FOSTI-UMS/esp32-doorlock/README.md

# Sistem Kunci Pintu dengan Sidik Jari Menggunakan ESP32

## Deskripsi
Proyek ini merupakan sistem pengunci pintu yang memanfaatkan teknologi sidik jari dengan menggunakan perangkat ESP32. Sistem ini memberikan tingkat keamanan yang optimal karena setiap individu memiliki sidik jari yang unik, sehingga hanya orang yang terdaftar yang dapat mengakses. Selain itu, proyek ini juga dapat mencegah potensi pembobolan, memberikan keamanan tambahan, dan memberikan tampilan yang lebih modern.

## Pembaharuan dari Versi Sebelumnya
Dalam versi terbaru ini, kami telah melakukan beberapa pembaruan untuk meningkatkan pengalaman pengguna, antara lain:

1. **Pembaruan Tampilan:**
   - Tampilan sistem kunci pintu telah diperbarui untuk memberikan kesan rapi, aman, dan portabel.

2. **Penambahan LCD:**
   - Kami menambahkan layar LCD untuk memberikan informasi lebih rinci kepada pengguna, seperti status kunci dan instruksi pendaftaran sidik jari.

3. **Perubahan UI:**
   - Antarmuka pengguna (UI) server telah diubah agar lebih mudah dipahami dan digunakan oleh pengguna.

4. **Penambahan Fitur:**
   - Beberapa fitur baru telah ditambahkan untuk meningkatkan fungsionalitas sistem, seperti hapus data sidik jari dan empty database.

5. **Pembaruan Perkabelan:**
   - Perkabelan sistem telah diperbarui untuk meningkatkan stabilitas dan kinerja keseluruhan.

## Daftar Isi
- [How to Install Door-Lock System](https://github.com/FOSTI-UMS/esp32-doorlock/blob/main/Manual%20User%20Door-lock%20System/How%20to%20install.md)
- [How to Use Door-Lock System](https://github.com/FOSTI-UMS/esp32-doorlock/blob/main/Manual%20User%20Door-lock%20System/How%20to%20use.md)

## Tim Kami
* Ahmat Zainul Muttaqin
* Muhammad Wahyu Syafi’uddin
* Muhammad Rivai Putra R
* Agung Nur Hidayat
* Muhammad Rafli Silehu
* Mhd. Farhan Lubis
* Pandu Adi Wijaya Kusuma W
* Hernanda Lilih Kusumaningtyas
* Sakha Naufal Firmansyah
* Dian Sasya Fitriani
* Almira Putri Wibowo
* Luthfiana Azzalea Afifah
* Naufal Zul Helmi Maulana
* Achmad Mustofa
