FOSTI-UMS/esp32-doorlock/assets/board/board3d.png

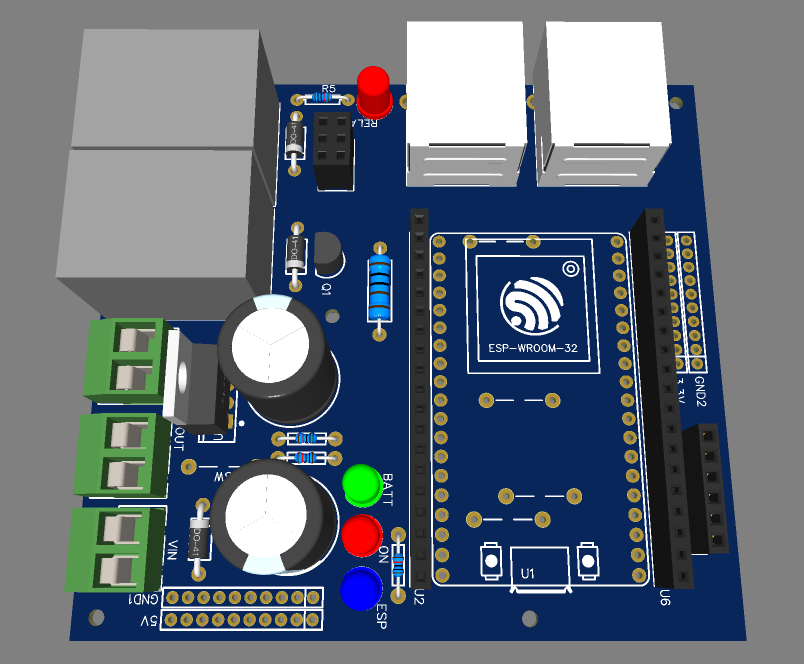
assets/board/board3d.png
