FOSTI-UMS/esp32-doorlock/assets/board/boardBottom.png

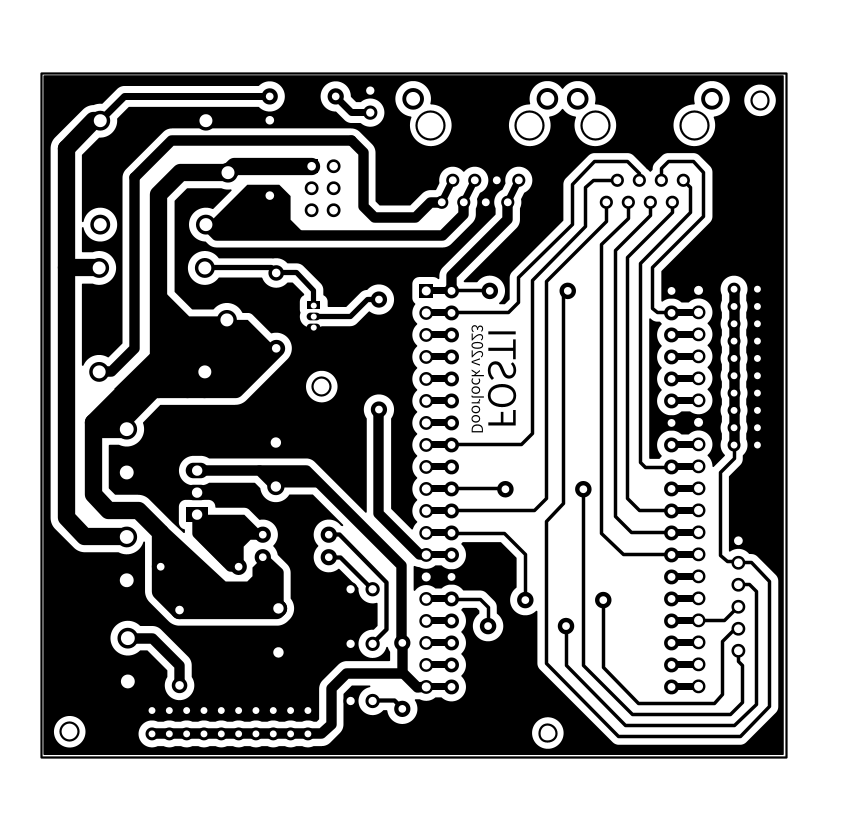
assets/board/boardBottom.png
