FOSTI-UMS/esp32-doorlock/assets/board/boardTop.png

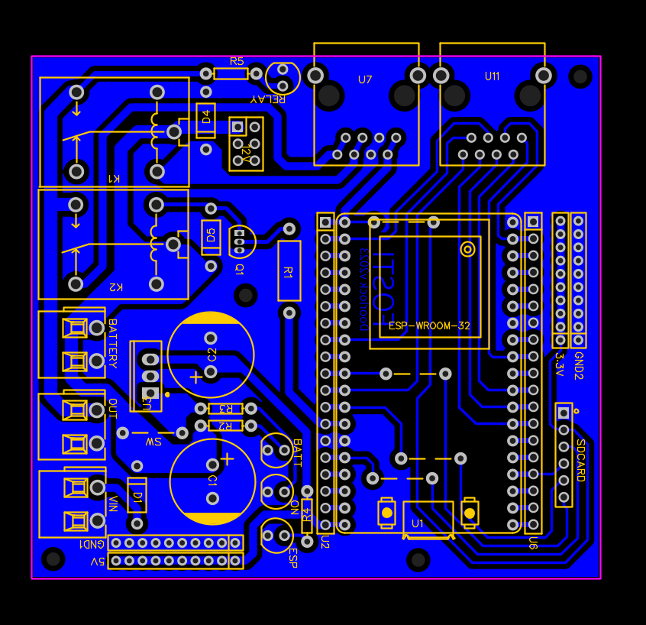
assets/board/boardTop.png
