FOSTI-UMS/esp32-doorlock/assets/board/box.jpeg

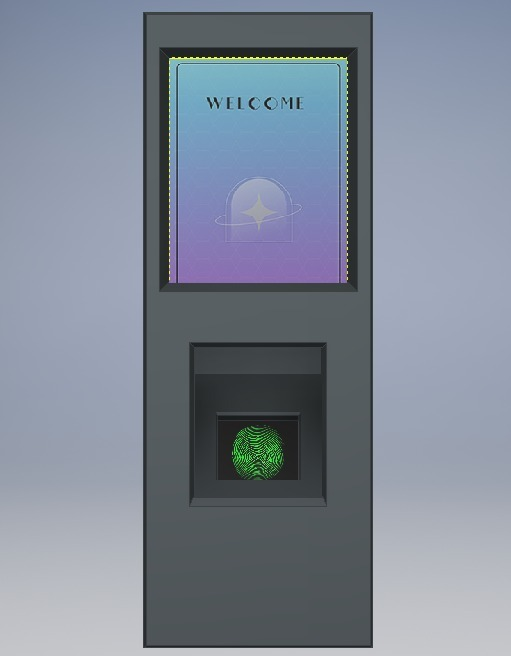
assets/board/box.jpeg
