FOSTI-UMS/esp32-doorlock/assets/board/panel3d.png

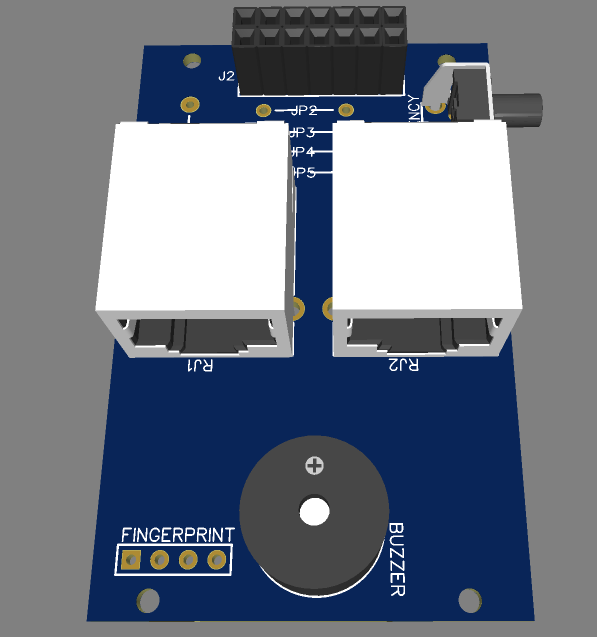
assets/board/panel3d.png
