FOSTI-UMS/esp32-doorlock/assets/board/panelBottom.png

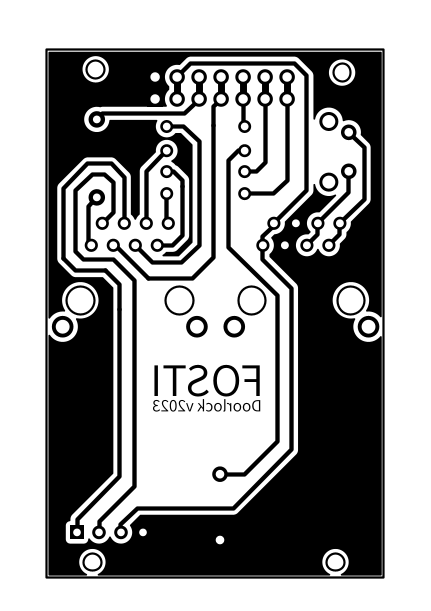
assets/board/panelBottom.png
