FOSTI-UMS/esp32-doorlock/assets/board/panelTop.png

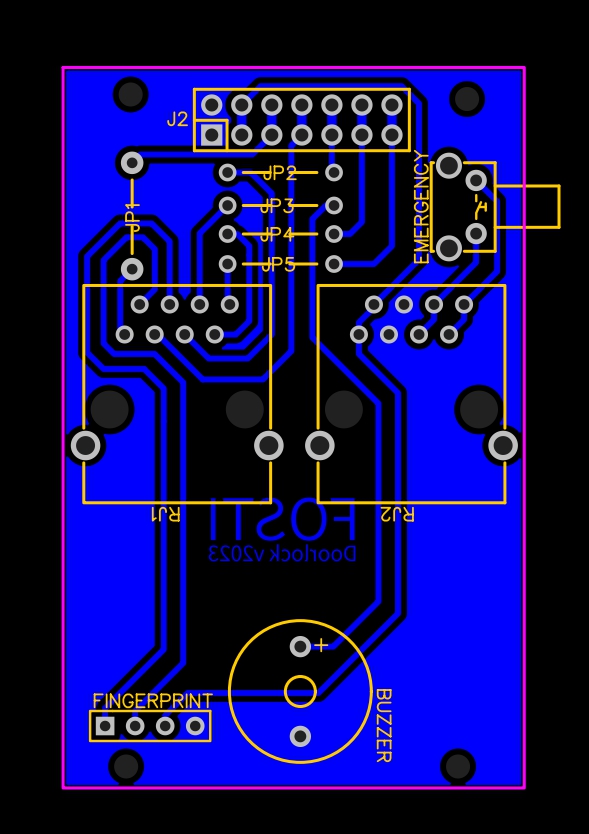
assets/board/panelTop.png
