FOSTI-UMS/esp32-doorlock/Manual User Door-lock System/How to install.md

# How to Install Door-Lock System

Powered By FOSTI UMS

✨ Door-lock system with fingerprint✨  

## Installation
### Langkah 1: Menyiapkan Alat dan Bahan
Bahan :
1. Modul NodeMCU ESP32
2. PCB Board
3. Modul Fingerprint
4. LCD TFT ST7789
5. Antenna
6. Battery 12V
7. Battery Management System (BMS)
8. Solenoid Lock
9. Elco, Resistor, LED, Dioda, Transistor, Terminal (Sesuai desain PCB Board)
10. Saklar
11. Buzzer
12. Adaptor 12-14 V
13. Kabel Jumper

Alat :
1. PC/Laptop
2. Micro-USB to USB cable
3. Breadboard

### Langkah 2: Menginstall Software
1. Instal Arduino IDE pada perangkat komputer Anda.

### Langkah 3: Menghubungkan Perangkat
Ikuti skema koneksi pada gambar . Pastikan semua komponen telah terhubung dengan benar.

### Langkah 4: Menghubungkan ESP32 ke Komputer
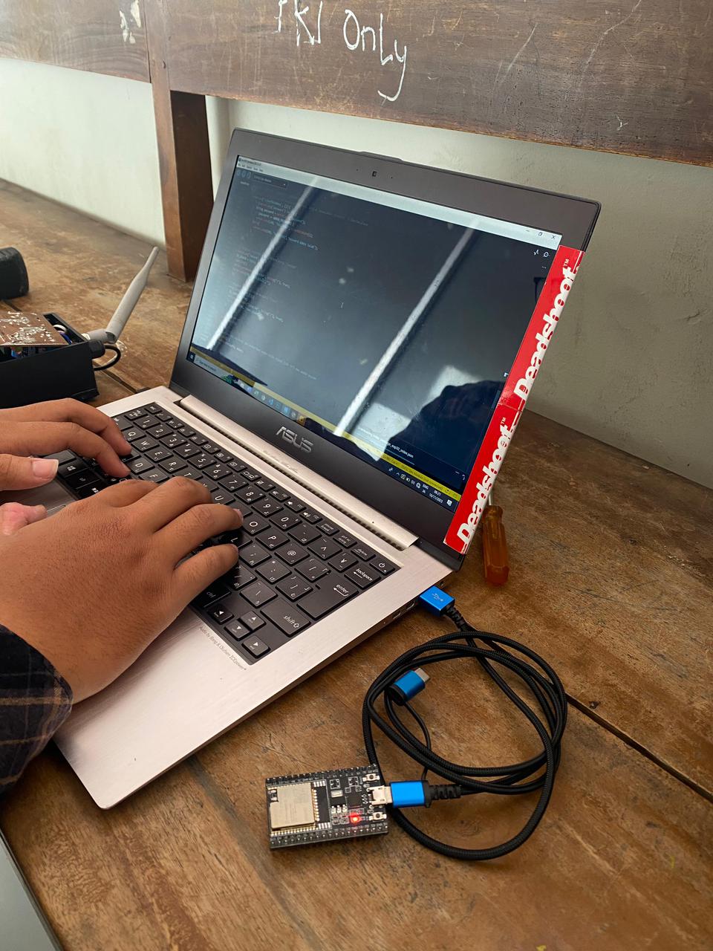
[picture p15: assets/assembling/assembling1.jpeg]
Sambungkan ESP32 ke komputer menggunakan kabel USB. Lihat gambar .

### Langkah 5: Membuka Arduino IDE
Buka Arduino IDE di komputer Anda.

### Langkah 6: Menginstall Library
Instal library berikut pada Arduino IDE:
1. Arduino
2. WiFi
3. SoftwareSerial
4. WiFiClient
5. WebServer
6. Adafruit_Fingerprint
7. SPI
8. ArduinoJson
9. TFT_eSPI

### Langkah 7: Konfigurasi library TFT_eSPI
Sebelum memulai konfigurasi, pastikan library TFT_eSPI sudah terinstall pada Arduino IDE. Setelah itu, ikuti langkah-langkah konfigurasi berikut:

1. Buka Arduino IDE.
2. Pilih tab "Sketch" (di bagian atas), kemudian pilih "Include Library" -> "TFT_eSPI" -> "User Setup file".
3. Buka file User_Setup_ST7789.h pada direktori library TFT_eSPI.
4. Konfigurasi beberapa bagian kode seperti berikut ini:
   ```cpp
   #define ST7789_2_DRIVER
   #define TFT_SDA_READ
   #define TFT_WIDTH  240  // Disesuaikan dengan lebar layar LCD
   #define TFT_HEIGHT 320  // Disesuaikan dengan tinggi layar LCD
   #define TFT_MOSI 23
   #define TFT_SCLK 18
   #define TFT_CS 15
   #define TFT_DC 2
   #define TFT_RST 4
   #define LOAD_GLCD
   #define LOAD_FONT2
   #define LOAD_FONT4
   #define LOAD_FONT6
   #define LOAD_FONT7
   #define LOAD_FONT8
   #define LOAD_GFXFF
   #define SMOOTH_FONT
   #define SPI_FREQUENCY  27000000
   #define SPI_READ_FREQUENCY  20000000
   #define SPI_TOUCH_FREQUENCY  2500000
5. Simpan konfigurasi tersebut.
6. Buka file User_Setup_Select.h pada direktori library TFT_eSPI.
7. Konfigurasi bagian kode seperti berikut ini:
   ```cpp
   #include <User_Setups/User_Setup_ST7789.h>
8. Simpan konfigurasi tersebut.
9. Selain kode tersebut, biarkan tetap konfigurasi default.
   
### Langkah 8: Salin Kode
Salin kode dari file [src/main.ino](https://github.com/FOSTI-UMS/esp32-doorlock/blob/main/src/main.ino) dan pastekan ke dalam Arduino IDE.

### Langkah 9: Memilih Board dan Port
Pilih board dan port yang sesuai dengan ESP32 Anda pada Arduino IDE. Lihat gambar ![](https://github.com/FOSTI-UMS/esp32-doorlock/blob/main/assets/install/port.png).

### Langkah 10: Kompilasi dan Unggah
Klik tombol kompilasi (ikon ceklis) untuk memastikan tidak ada kesalahan dalam kode. Setelah itu, klik tombol unggah (ikon panah menghadap ke kanan) untuk mengunggah program ke ESP32. Tunggu hingga proses kompilasi selesai. Lihat gambar ![](https://github.com/FOSTI-UMS/esp32-doorlock/blob/main/assets/install/compile.png), ![](https://github.com/FOSTI-UMS/esp32-doorlock/blob/main/assets/install/waiting.png).

### Catatan Penting:
Pastikan bahwa ESP32 telah terhubung dengan komputer melalui kabel USB sebelum mengompilasi atau mengunggah program.

Setelah langkah-langkah di atas selesai, Door-Lock System dengan fingerprint seharusnya dapat berfungsi dengan baik.

## License
MIT

**FOSTI UMS 2023**
