FOSTI-UMS/esp32-doorlock/assets/assembling/assembling2.jpeg

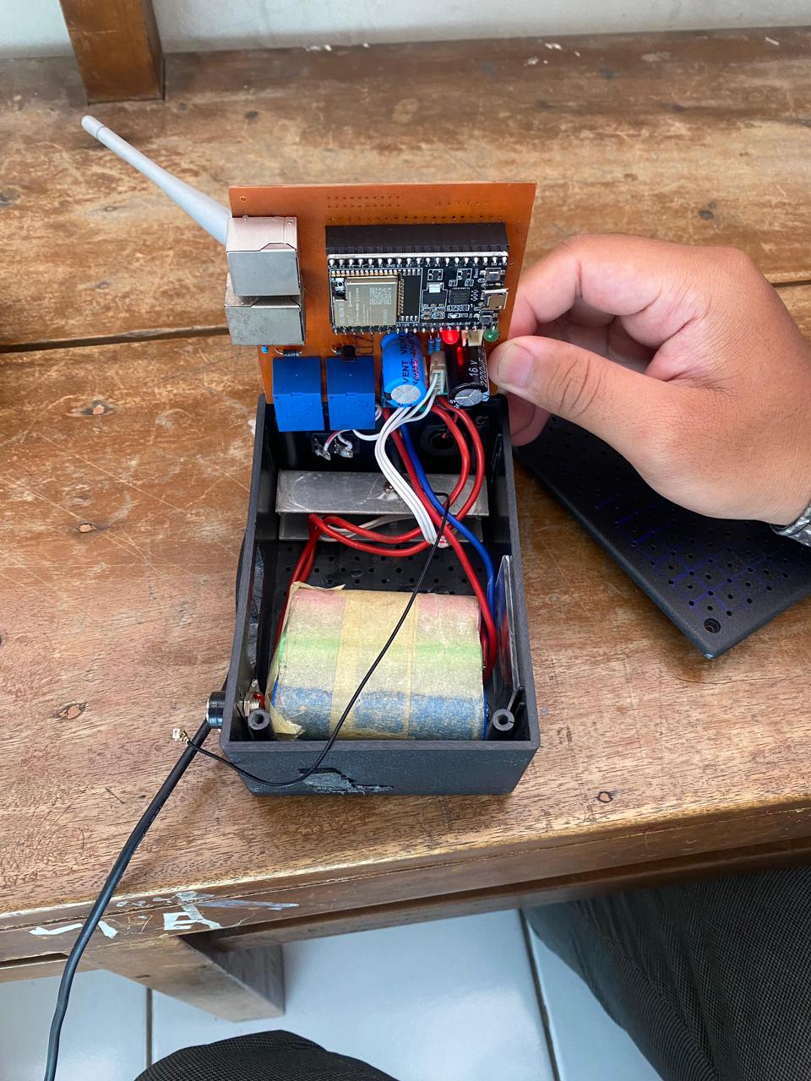
assets/assembling/assembling2.jpeg
