FOSTI-UMS/esp32-doorlock/assets/assembling/assembling3.jpeg

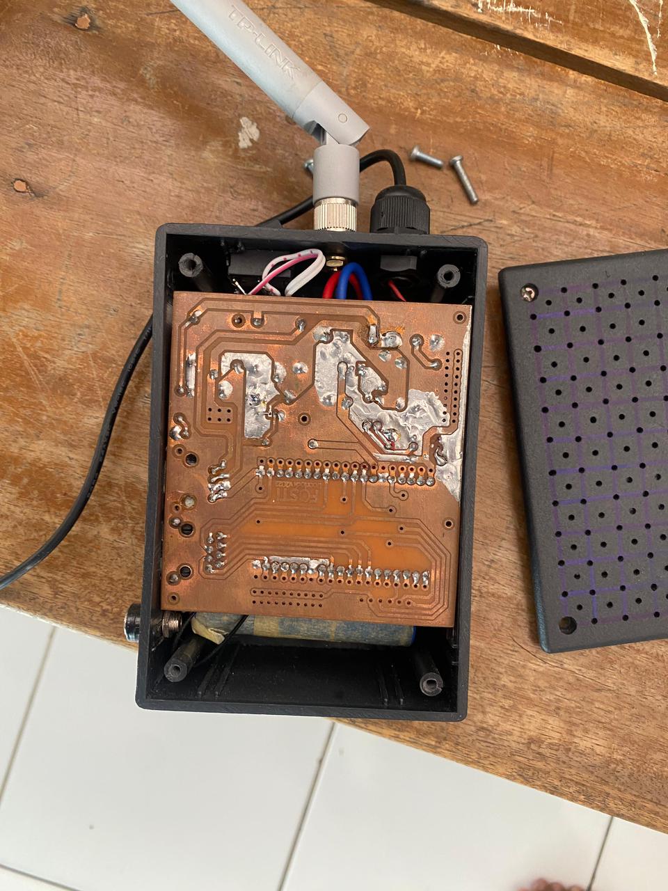
assets/assembling/assembling3.jpeg
