FOSTI-UMS/esp32-doorlock/assets/assembling/assembling4.jpeg

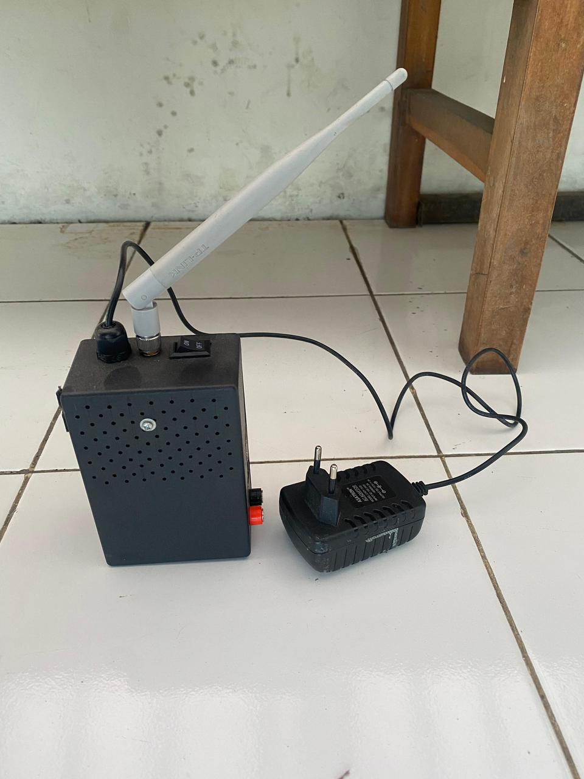
assets/assembling/assembling4.jpeg
