FOSTI-UMS/esp32-doorlock/assets/assembling/assembling5.jpeg

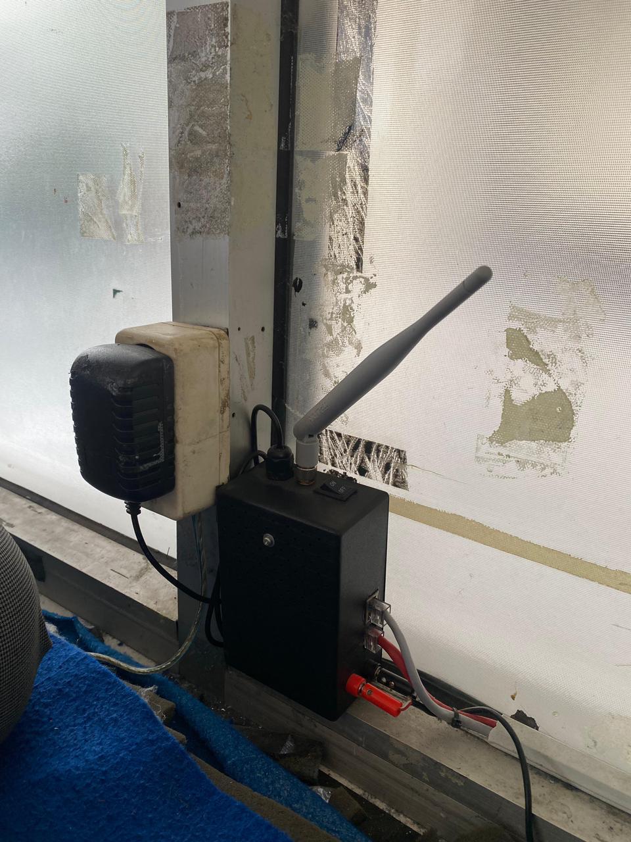
assets/assembling/assembling5.jpeg
