FOSTI-UMS/esp32-doorlock/assets/assembling/assembling6.jpeg

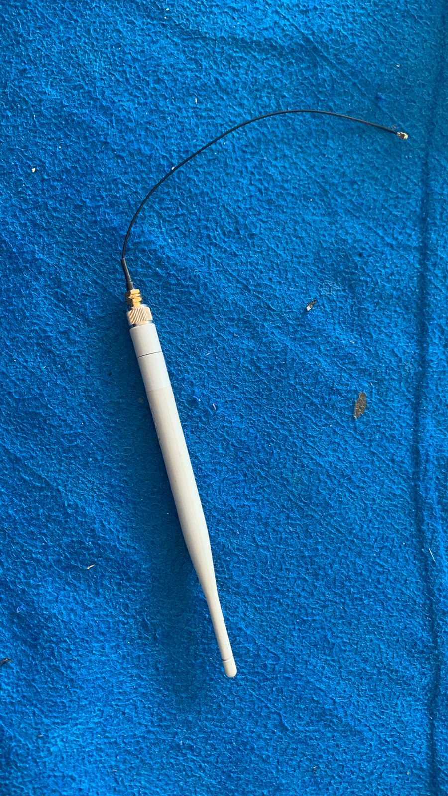
assets/assembling/assembling6.jpeg
