FOSTI-UMS/esp32-doorlock/assets/assembling/assembling7.jpeg

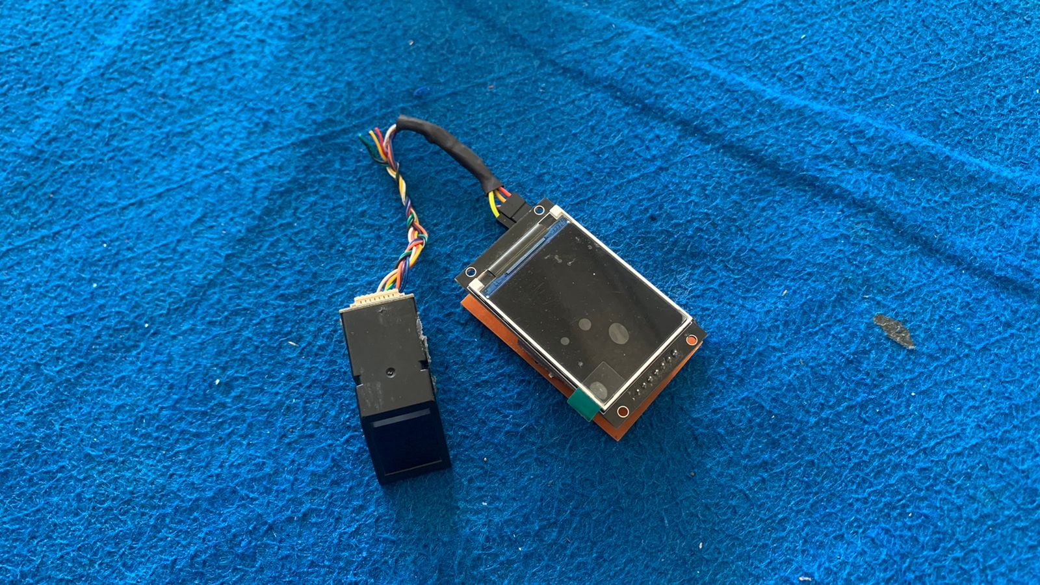
assets/assembling/assembling7.jpeg
