FOSTI-UMS/esp32-doorlock/assets/assembling/assembling8.jpeg

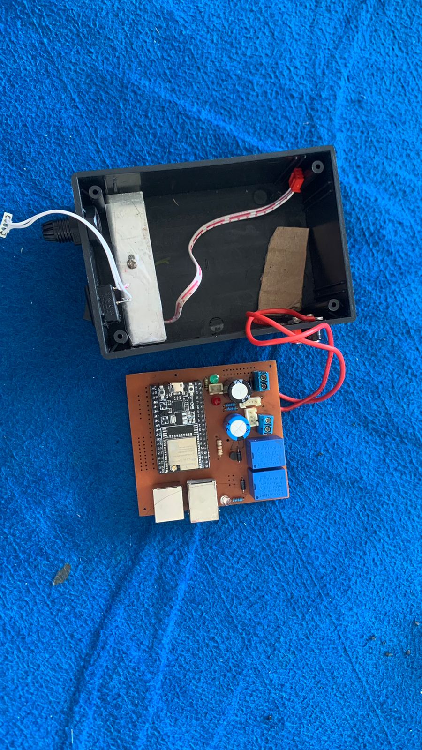
assets/assembling/assembling8.jpeg
