FOSTI-UMS/esp32-doorlock/assets/assembling/assembling9.jpeg

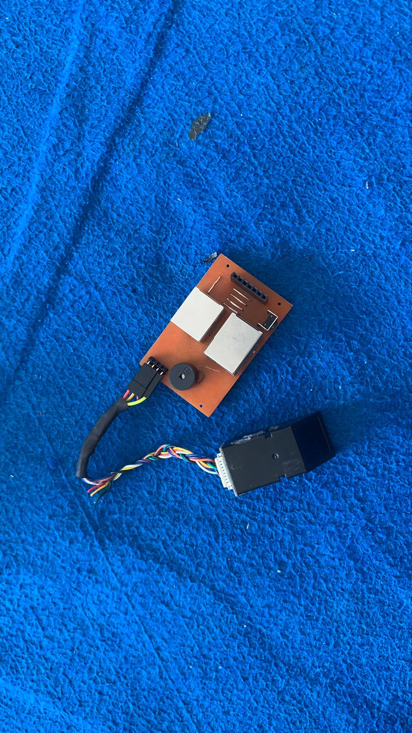
assets/assembling/assembling9.jpeg
