FOSTI-UMS/esp32-doorlock/assets/assembling/assembling10.jpeg

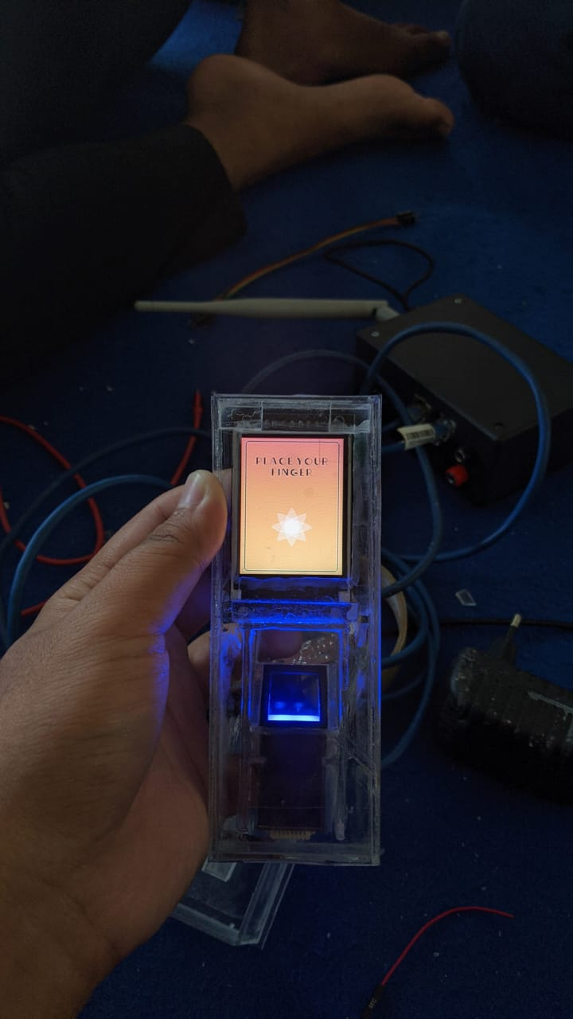
assets/assembling/assembling10.jpeg
