FOSTI-UMS/esp32-doorlock/assets/assembling/assembling11.jpeg

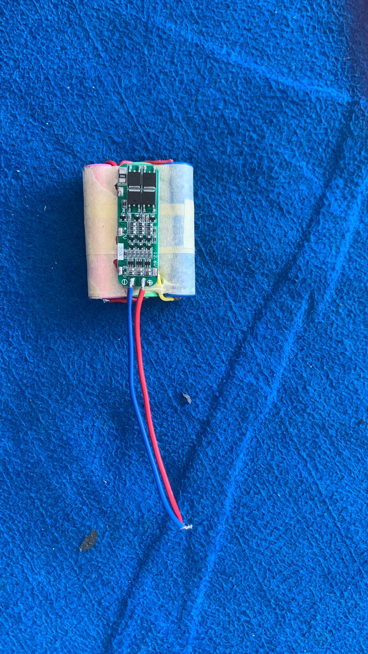
assets/assembling/assembling11.jpeg
