FOSTI-UMS/esp32-doorlock/assets/install/compile.png

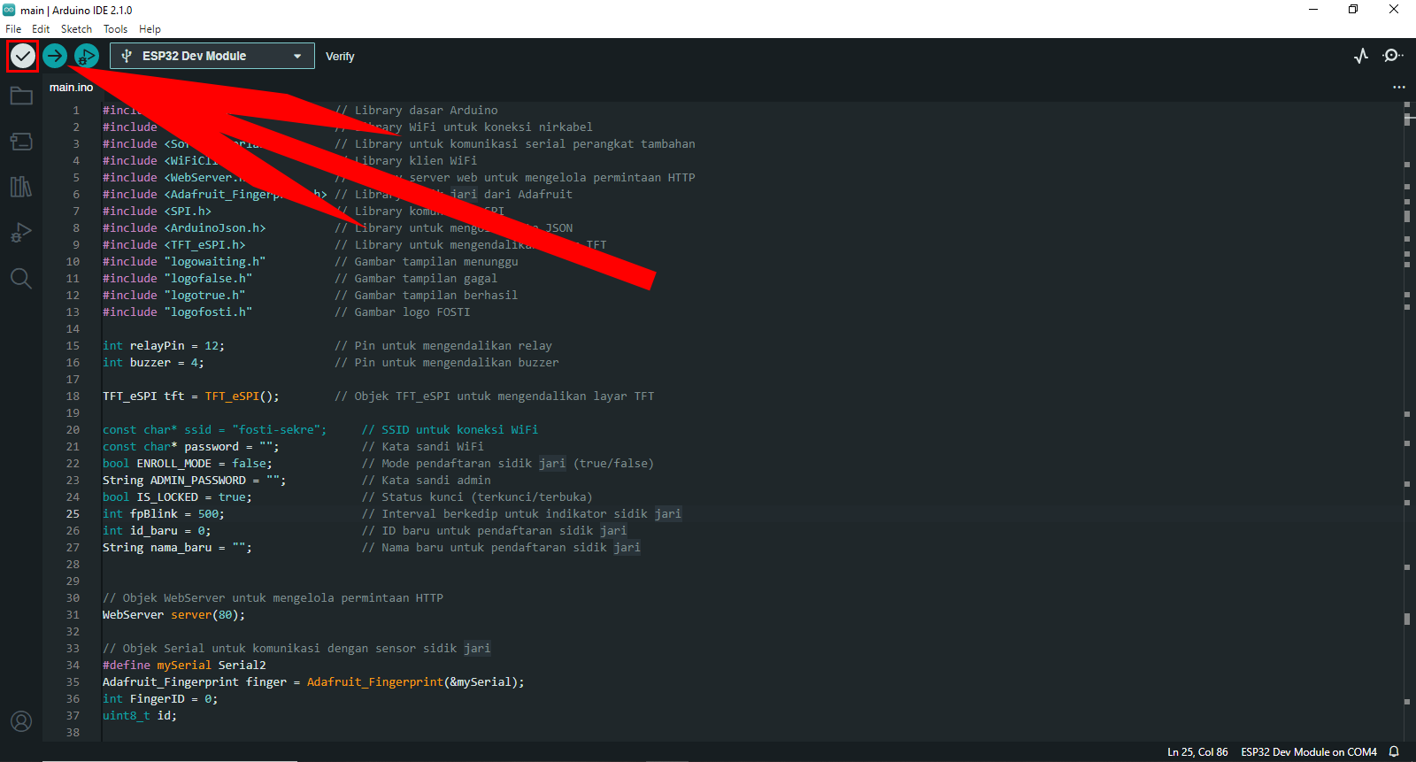
assets/install/compile.png
