FOSTI-UMS/esp32-doorlock/assets/install/main.png

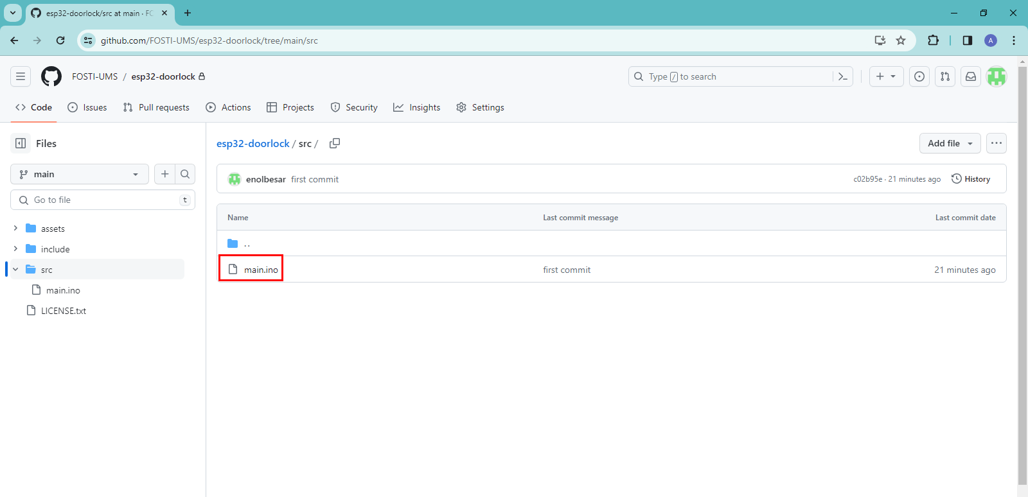
assets/install/main.png
