FOSTI-UMS/esp32-doorlock/assets/install/port.png

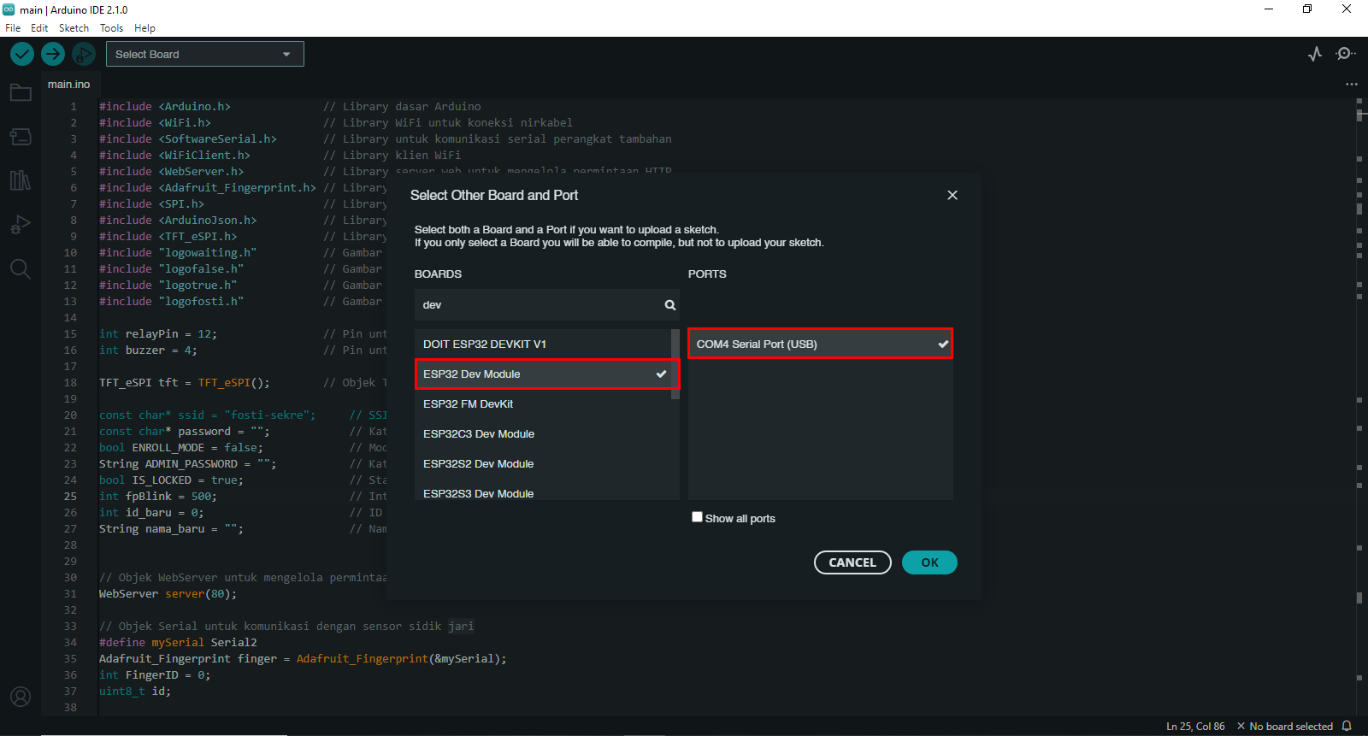
assets/install/port.png
