FOSTI-UMS/esp32-doorlock/assets/install/src.png

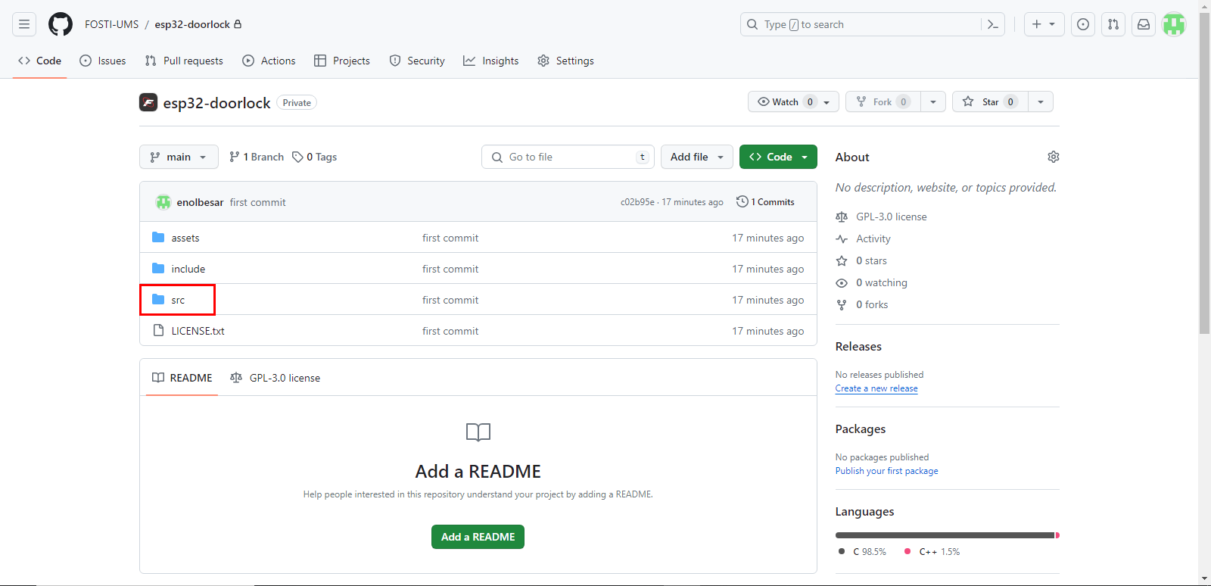
assets/install/src.png
