FOSTI-UMS/esp32-doorlock/assets/install/waiting.png

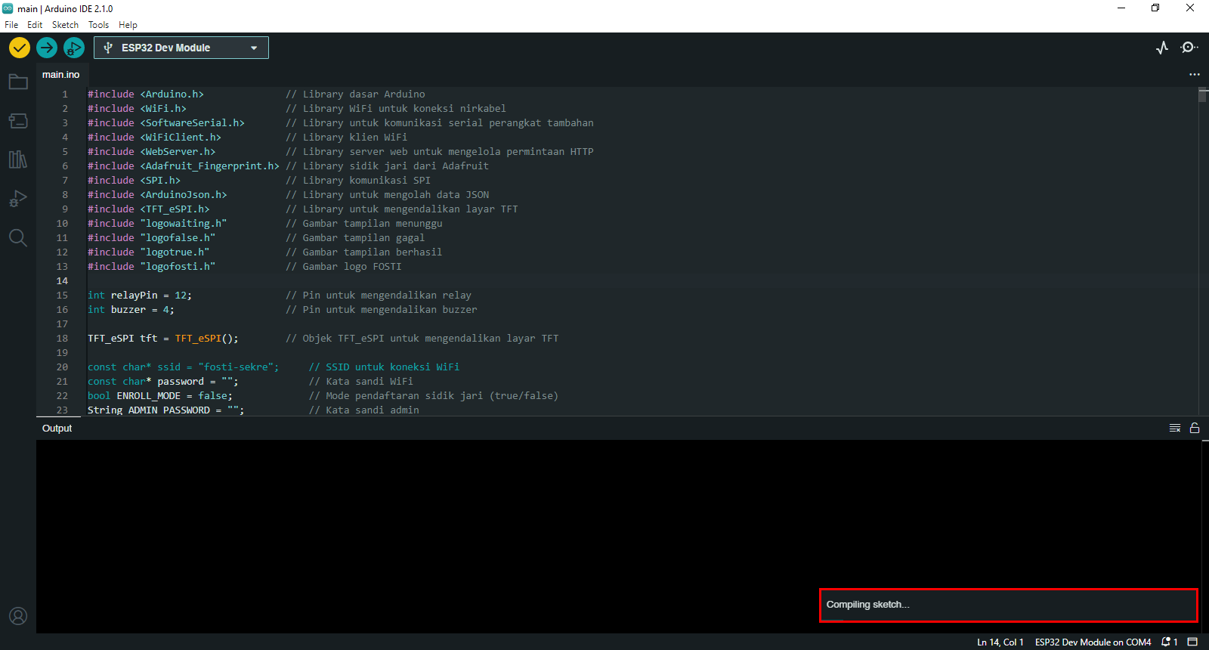
assets/install/waiting.png
