FOSTI-UMS/esp32-doorlock/include/logofosti.h

// Data piksel gambar logo fosti
const uint16_t logofosti[] PROGMEM  = {
  0xffff, 0xffff, 0xffff, 0xffff, 0xffff, 0xffff, 0xffff, 0xffff, 0xffff, 0xffff, 0xffff, 0xffff, 0xffff, 0xffff, 0xffff, 0xffff, 0xffff, 0xffff, 0xffff, 0xffff, 0xffff, 0xffff, 0xffff, 0xffff, 0xffff, 0xffff, 0xffff, 0xffff, 0xffff, 0xffff, 0xffff, 0xffff, 0xffff, 0xffff, 0xffff, 0xffff, 0xffff, 0xffff, 0xffff, 0xdfff, 0xbef7, 0x7def, 0x7df7, 0x7def, 0xb6b5, 0x8631, 0x8631, 0xa639, 0xa639, 0xa631, 0xa631, 0xa631, 0xa631, 0x8631, 0x8529, 0x18c6, 0xbef7, 0x9ef7, 0x9ef7, 0xbef7, 0xdfff, 0xffff, 0xffff, 0xffff, 0xffff, 0xffff, 0xffff, 0xffff, 0xffff, 0xffff, 0xffff, 0xffff, 0xffff, 0xffff, 0xffff, 0xffff, 0xffff, 0xffff, 0xffff, 0xffff, 0xffff, 0xffff, 0xffff, 0xffff, 0xffff, 0xffff, 0xffff, 0xffff, 0xffff, 0xffff, 0xffff, 0xffff, 0xffff, 0xffff, 0xffff, 0xffff, 0xffff, 0xffff, 0xffff, 0xffff, 
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
  0xdfff, 0x55ad, 0x494a, 0xa631, 0xa631, 0xa631, 0xa631, 0xa631, 0xa631, 0xa631, 0xa631, 0xa631, 0xa631, 0xa631, 0xa631, 0xa631, 0xa631, 0xa631, 0xa631, 0x8631, 0x8691, 0xa6f1, 0x86e9, 0xa6d9, 0x8549, 0xa731, 0xa631, 0xa631, 0xa631, 0xa631, 0xa631, 0xa631, 0xa631, 0xa631, 0xa631, 0xa631, 0xa631, 0xa639, 0x6531, 0x0421, 0x0c63, 0x3ce7, 0xffff, 0xffff, 0xffff, 0xffff, 0xffff, 0xffff, 0xffff, 0xffff, 0xffff, 0xffff, 0xffff, 0xffff, 0xffff, 0xffff, 0xffff, 0xffff, 0xffff, 0xffff, 0xffff, 0xffff, 0xffff, 0xffff, 0xffff, 0xffff, 0xffff, 0xffff, 0xffff, 0xffff, 0xffff, 0xffff, 0xffff, 0xffff, 0xffff, 0xffff, 0xffff, 0xffff, 0x5def, 0xeb5a, 0x4529, 0x8631, 0xa631, 0xa631, 0xa631, 0xa631, 0xa631, 0xa631, 0xa631, 0xa631, 0xa631, 0xa631, 0xa631, 0xa631, 0xa631, 0xa631, 0xa639, 0x6d6b, 0x79ce, 0xffff, 
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
};
